ManveerA/Capstone/README.md

Repository for Team 34's Capstone project: Demonstration of Electromechanical Relationships in a Controlled Electric Motor.

Team 34 Members:

Manveer Aujla - manveeraujla0226@gmail.com

Gavin Feher - gavin.feher@gmail.com

Adam DePinto - depintoadam@gmail.com

Last updated: 2025-08-01
