ManveerA/Capstone/Oscilloscope_Data/README

CSV files of data captured from RIGOL DH0804 oscilloscope. Contains all signals from Sensing and Interfacing PCB.
