ManveerA/Capstone/Motor_Control/README

The Trinamic Motion Control Language (TMCL) script for controlling the TMCM-1640 controller/driver to drive the QBL4208 BLDC motor.
Author: Manveer Aujla
Contact: manveeraujla0226@gmail.com
