ManveerA/Capstone/Sensing_Interfacing_PCB/README

All design files for the custom Sensing and Interfacing (S&I) PCB.
Designer: Manveer Aujla
Contact: manveeraujla0226@gmail.com
