ManveerA/Capstone/Custom_Motor_Mount/v2 Capstone BLDC Motor Bracket.stl

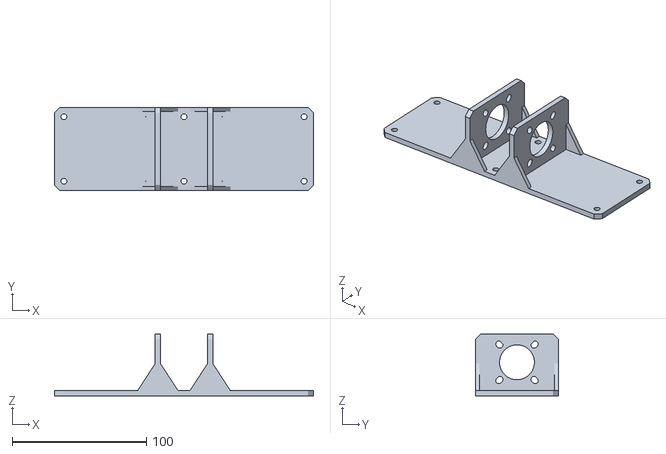
[picture p2: CAD file, 2025-07-31]
Custom_Motor_Mount/v2 Capstone BLDC Motor Bracket.stl
193.0 x 62.0 x 46.0
