ManveerA/Capstone/Sensing_Interfacing_PCB/B5B_PH_K_S/B5B-PH-K-S.STEP

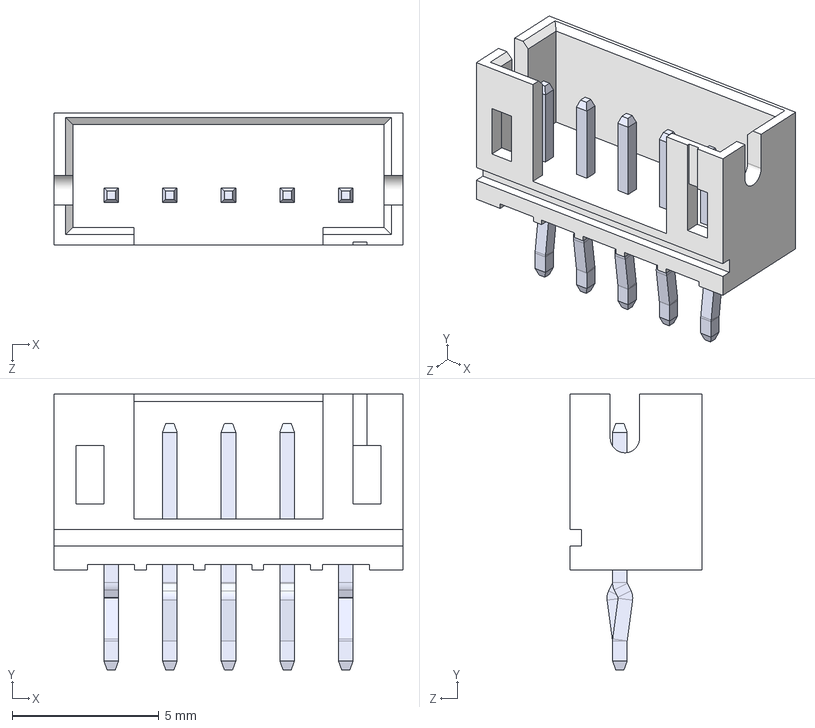
[picture p3: CAD file, 2025-07-31]
Sensing_Interfacing_PCB/B5B_PH_K_S/B5B-PH-K-S.STEP
11.9 x 9.40 x 4.50 mm
