ManveerA/Capstone/Sensing_Interfacing_PCB/LIB_ACS725LLCTR-05AB-T/ACS725LLCTR-05AB-T/3D/ACS725LLCTR-05AB-T.stp

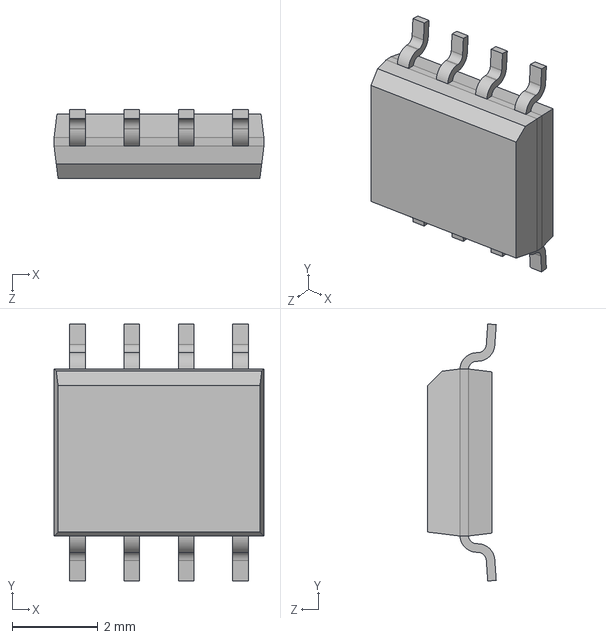
[picture p4: CAD file, 2025-07-31]
Sensing_Interfacing_PCB/LIB_ACS725LLCTR-05AB-T/ACS725LLCTR-05AB-T/3D/ACS725LLCTR-05AB-T.stp
4.90 x 6.00 x 1.60 mm
