ManveerA/Capstone/Sensing_Interfacing_PCB/LM358AP/LM358AP.step

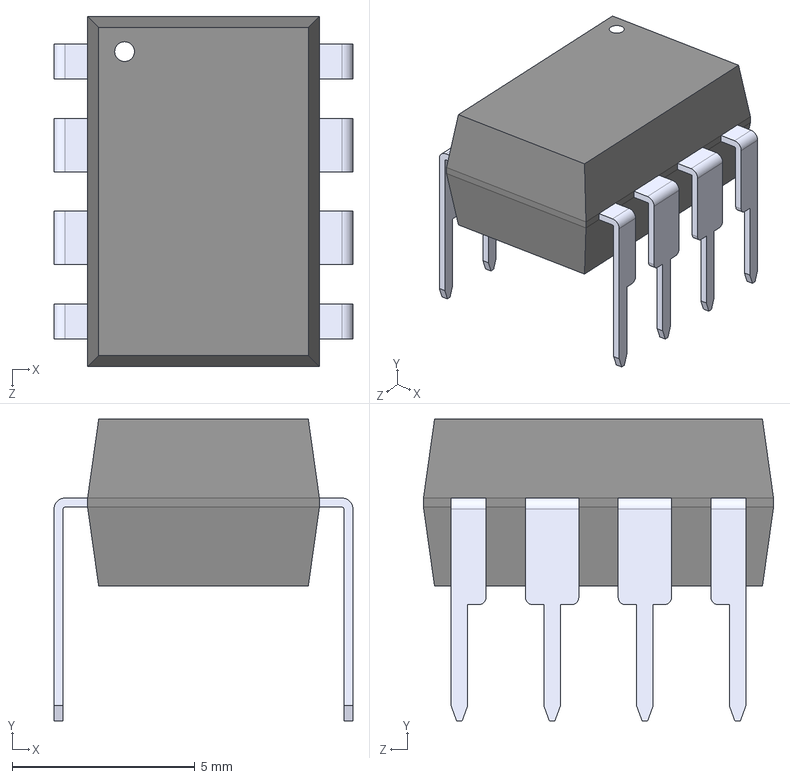
[picture p5: CAD file, 2025-07-31]
Sensing_Interfacing_PCB/LM358AP/LM358AP.step
8.19 x 8.26 x 9.59 mm
