ManveerA/Capstone/Sensing_Interfacing_PCB/61304021821/6130XX21821_61304021821.step

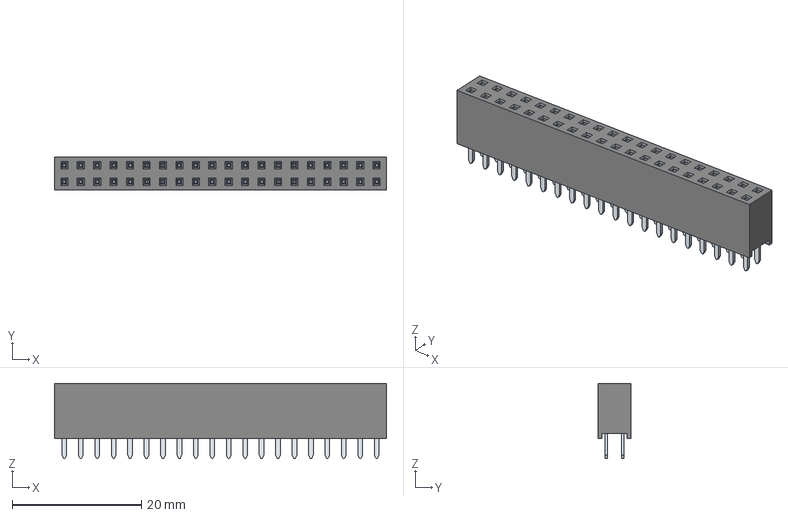
[picture p6: CAD file, 2025-07-31]
Sensing_Interfacing_PCB/61304021821/6130XX21821_61304021821.step
51.3 x 5.08 x 11.6 mm
6130xx21821_PIN x 40
