ManveerA/Capstone/Sensing_Interfacing_PCB/1935174/1935174.stp

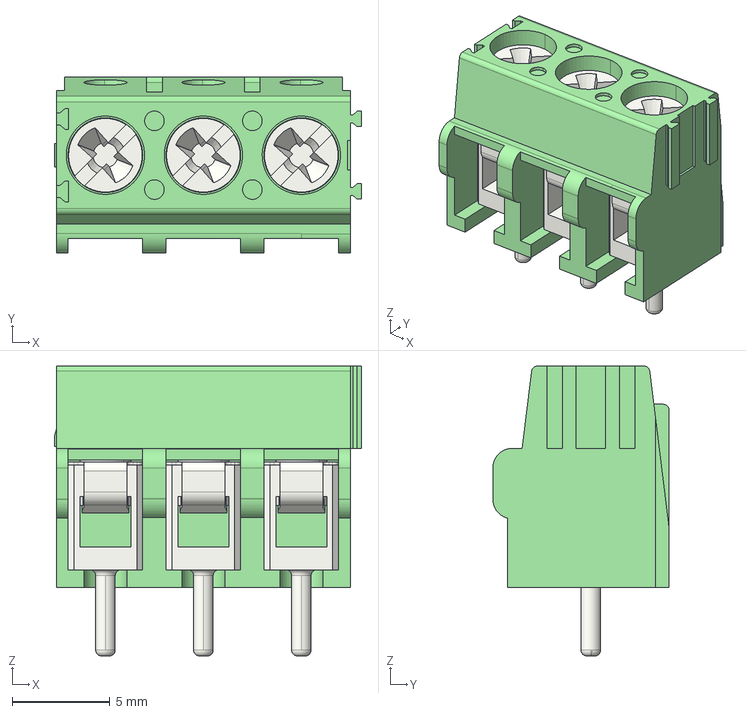
[picture p7: CAD file, 2025-07-31]
Sensing_Interfacing_PCB/1935174/1935174.stp
15.7 x 9.00 x 14.8 mm
