ManveerA/Capstone/Sensing_Interfacing_PCB/1935190/1935190.STEP

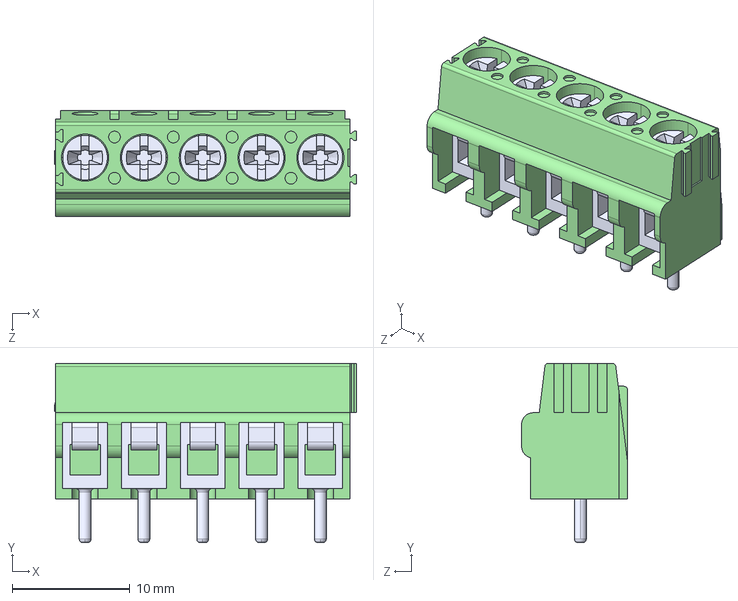
[picture p8: CAD file, 2025-07-31]
Sensing_Interfacing_PCB/1935190/1935190.STEP
25.7 x 15.2 x 9.00 mm
