ManveerA/Capstone/Sensing_Interfacing_PCB/1984646/1984646.stp

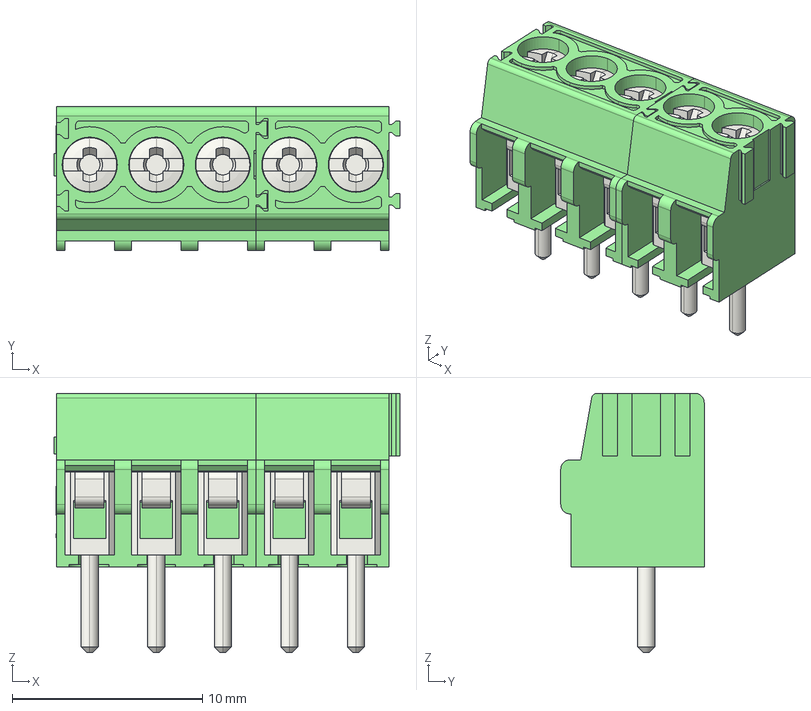
[picture p9: CAD file, 2025-07-31]
Sensing_Interfacing_PCB/1984646/1984646.stp
18.2 x 7.55 x 13.6 mm
