ManveerA/Capstone/Sensing_Interfacing_PCB/640456_3/640456-3.STEP

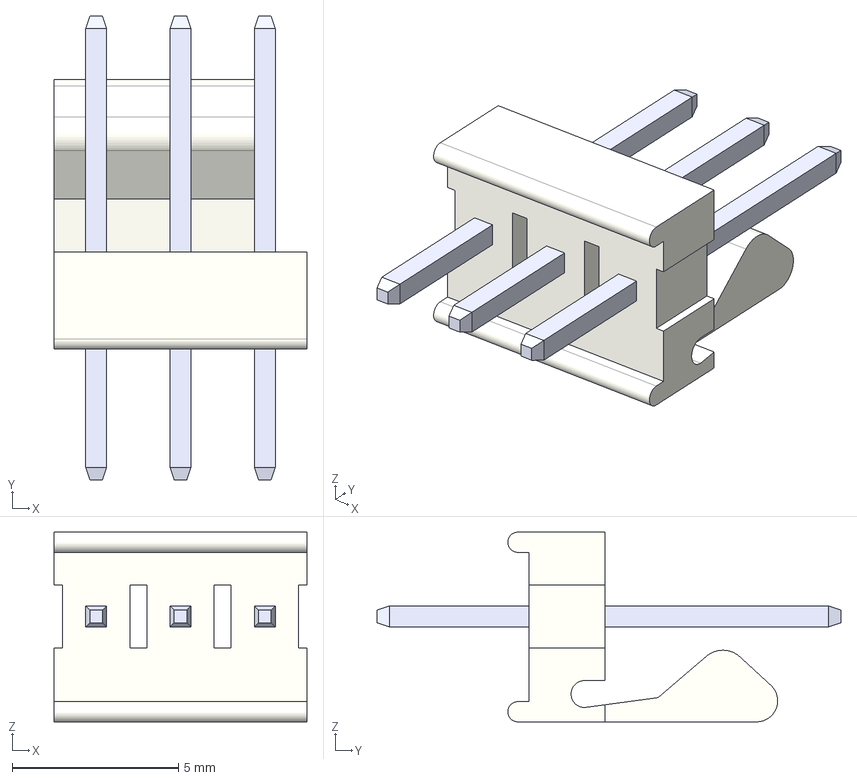
[picture p10: CAD file, 2025-07-31]
Sensing_Interfacing_PCB/640456_3/640456-3.STEP
7.62 x 14.0 x 5.71 mm
