ManveerA/Capstone/Sensing_Interfacing_PCB/Misc/971100154.stp

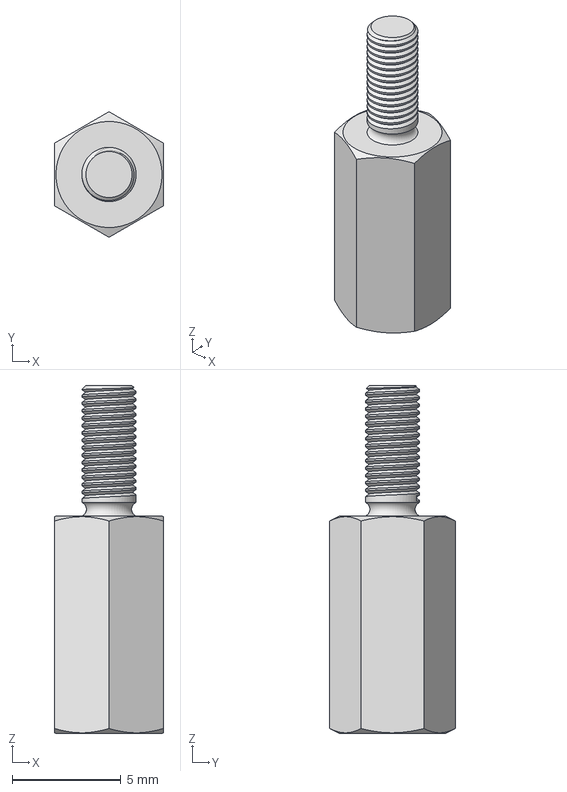
[picture p11: CAD file, 2025-07-31]
Sensing_Interfacing_PCB/Misc/971100154.stp
5.00 x 5.77 x 16.0 mm
