ManveerA/Capstone/(list of files, cad)

Other CAD files:
Custom_Motor_Mount/v2 Capstone BLDC Motor Bracket.f3d
Sensing_Interfacing_PCB/LIB_ACS725LLCTR-05AB-T/ACS725LLCTR-05AB-T/Allegro/soic127p600x175-8n.psm
Sensing_Interfacing_PCB/LIB_ACS725LLCTR-05AB-T/ACS725LLCTR-05AB-T/DEHDL/acs725llctr_05ab_t/chips/chips.prt
