ManveerA/Capstone/Sensing_Interfacing_PCB/Layout.pdf

# J5 U4 R15

# C8 R²⁵ U2

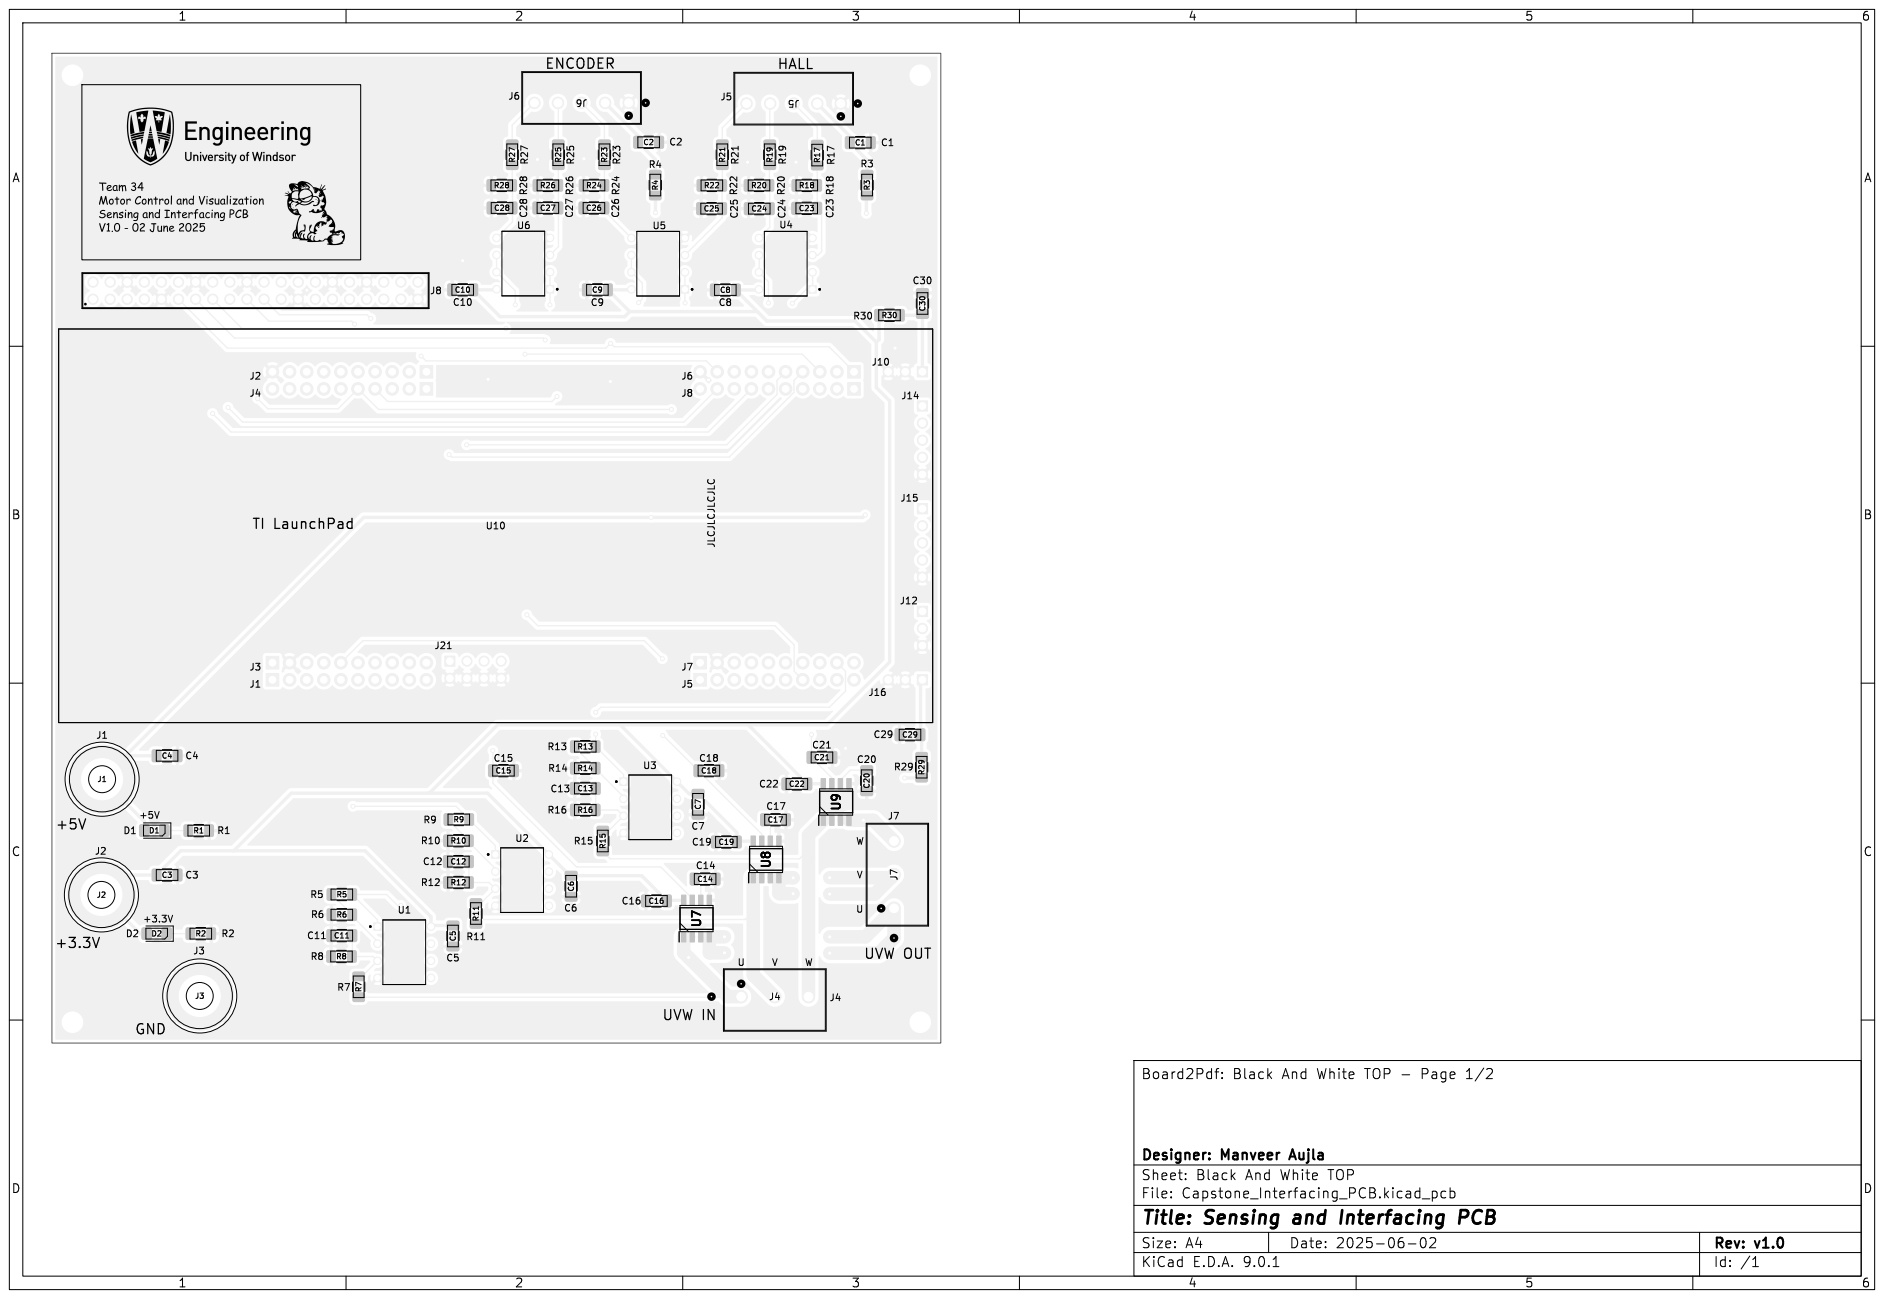
[picture p12: page 1]

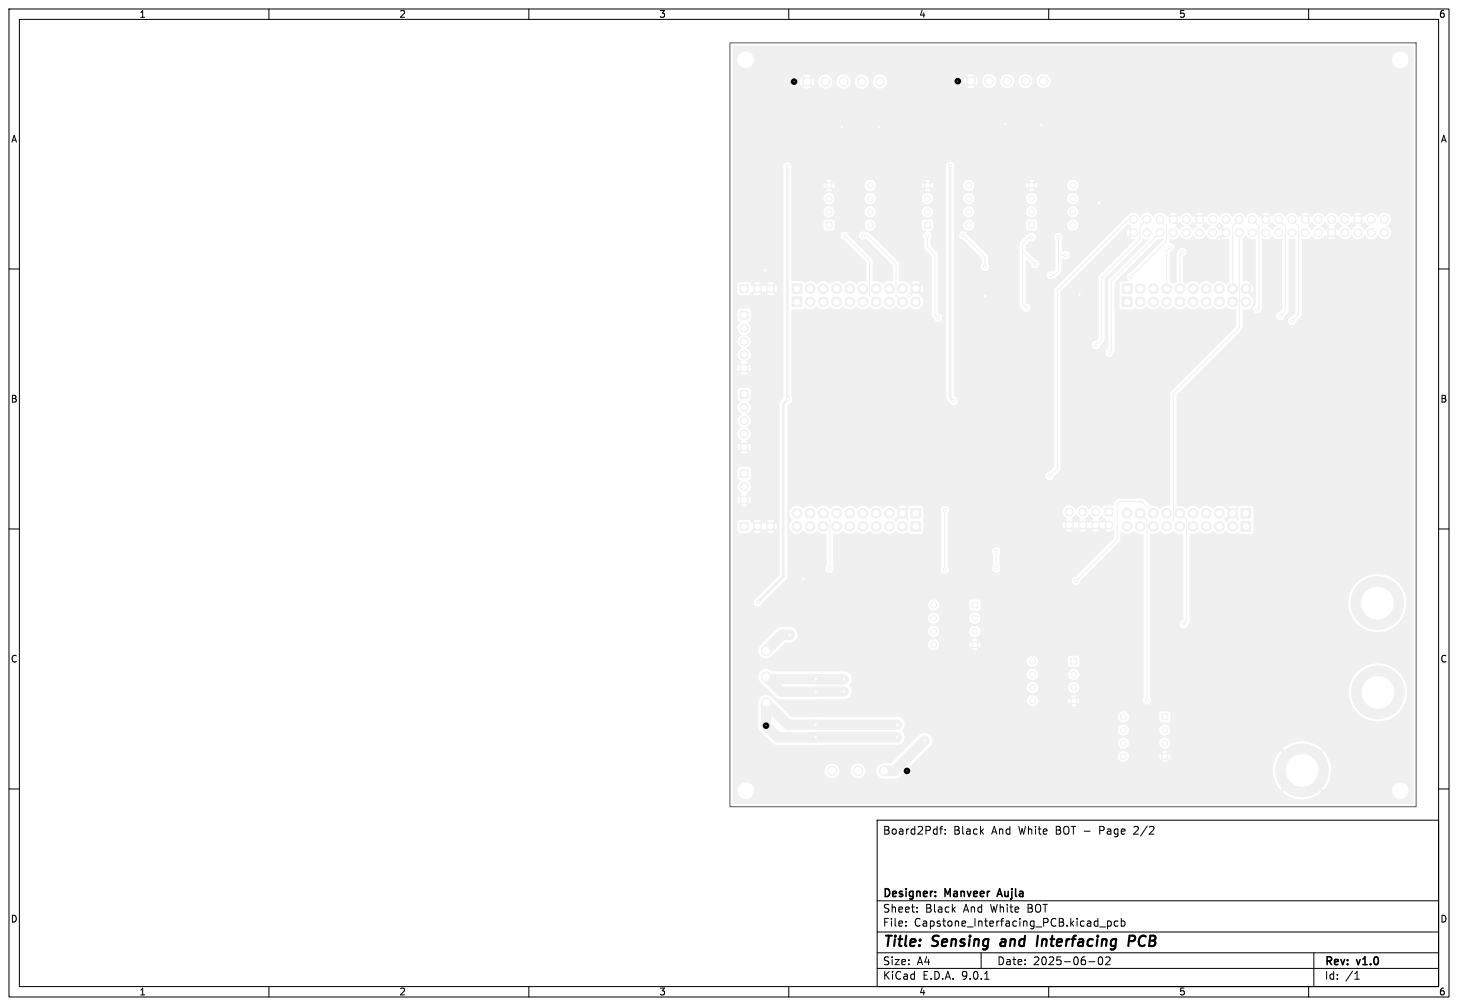
[picture p13: page 2]
D Date: 2025-06-02 KiCad; E.D.A. 9.0.1 Size: A4; Rev: v1.0; Id: /1 Title: Sensing and Interfacing; PCB; File: Capstone_Interfacing_PCB.kicad_pcb Sheet: Black; And; White; BOT Designer:; Manveer Aujla Board2Pdf:; Black; BOT -; Page 2/2
