ManveerA/Capstone/Sensing_Interfacing_PCB/Schematic.pdf

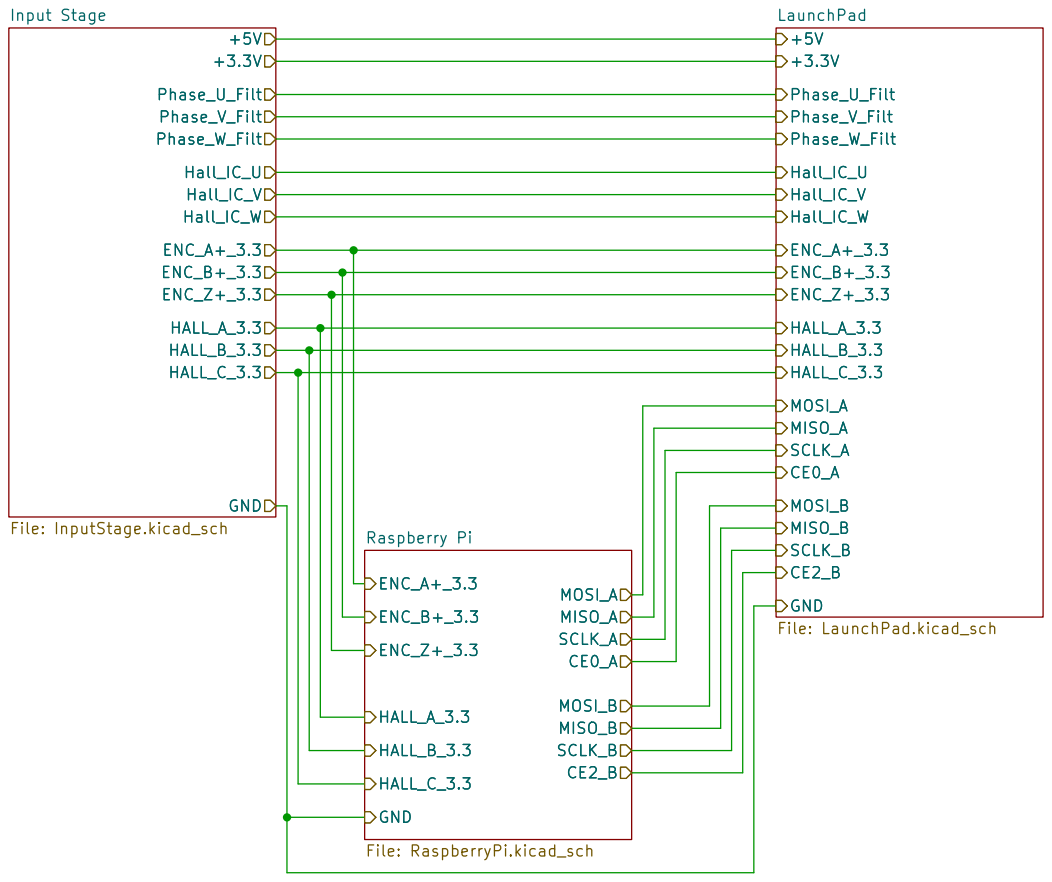
[picture p14: page 1]

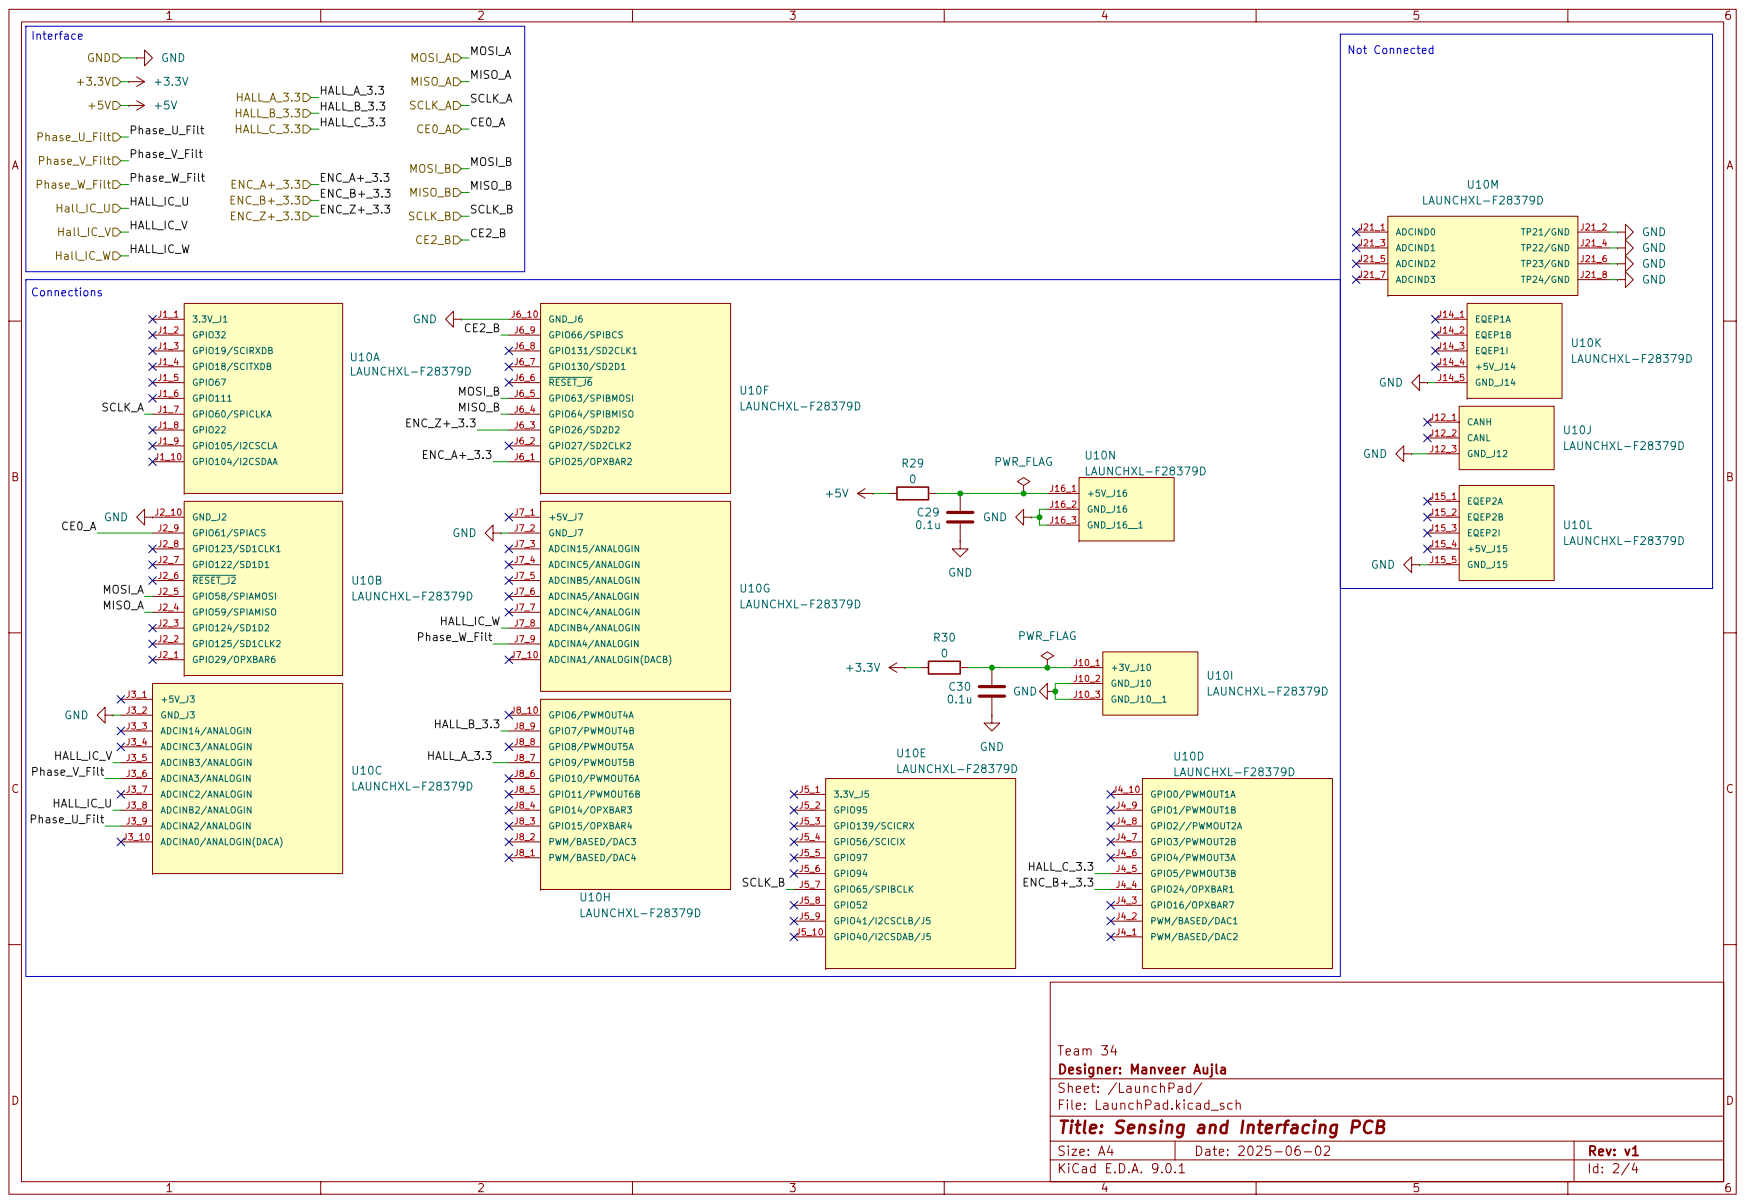
[picture p15: page 2]

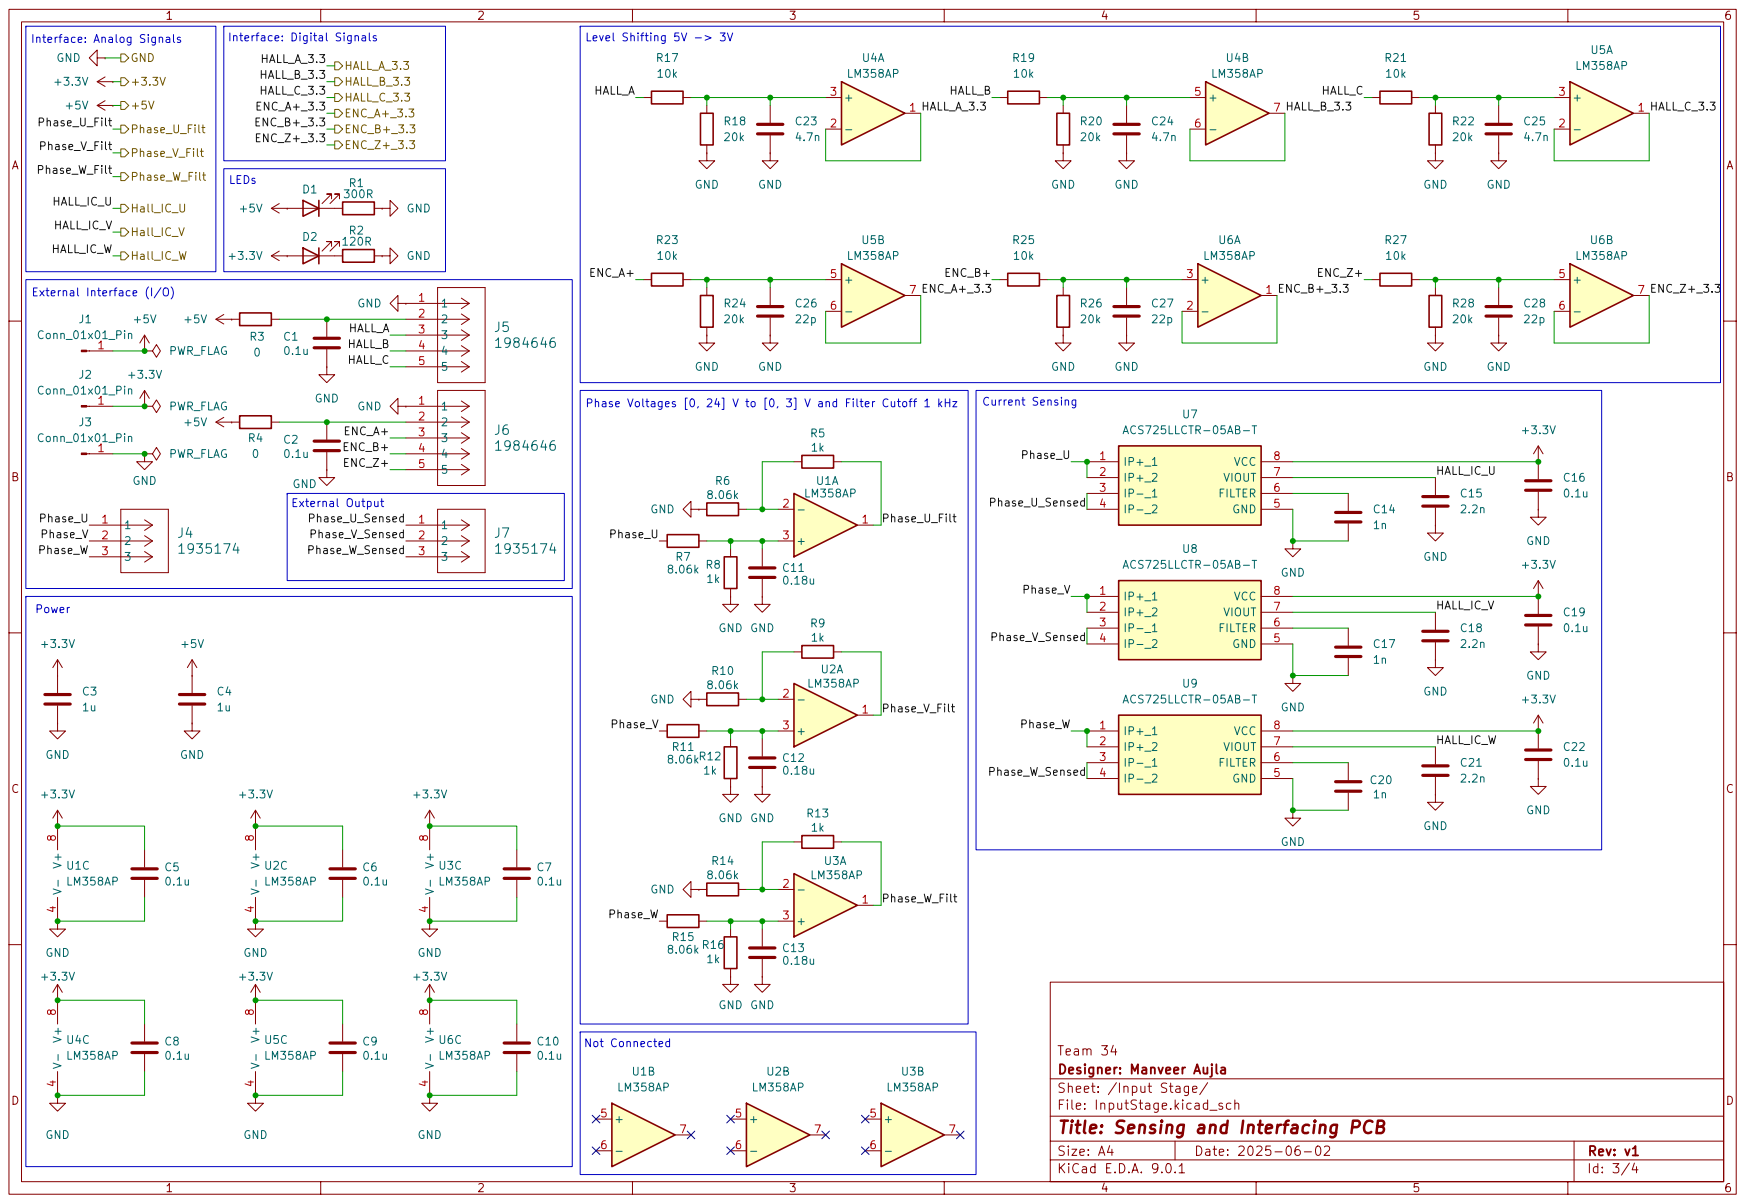
[picture p16: page 3]

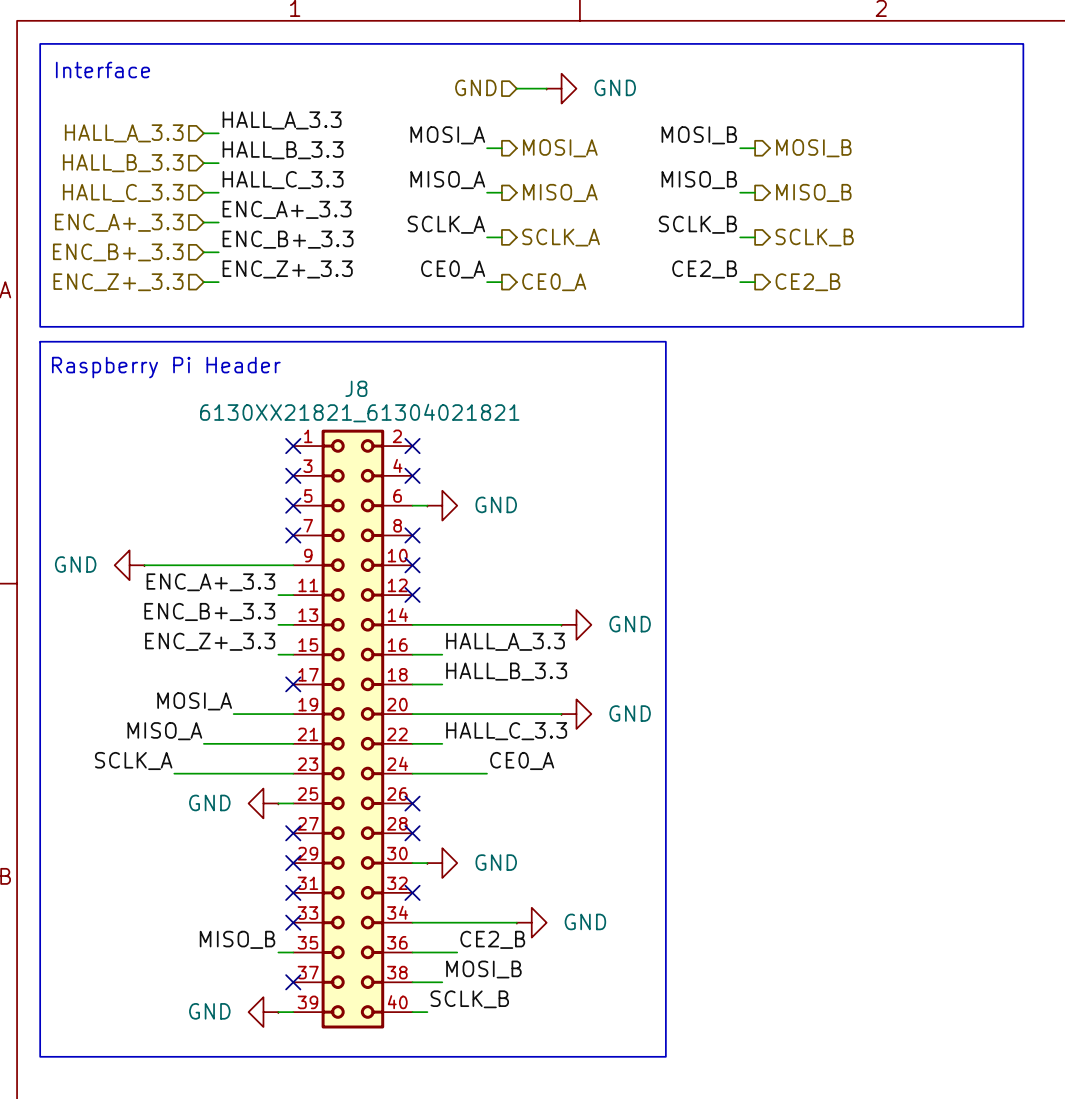
[picture p17: page 4]
