ManveerA/Capstone/Sensing_Interfacing_PCB/Capstone_Interfacing_PCB.kicad_pcb

## KiCad design Sensing_Interfacing_PCB/Capstone_Interfacing_PCB.kicad_pcb (2025-07-31)

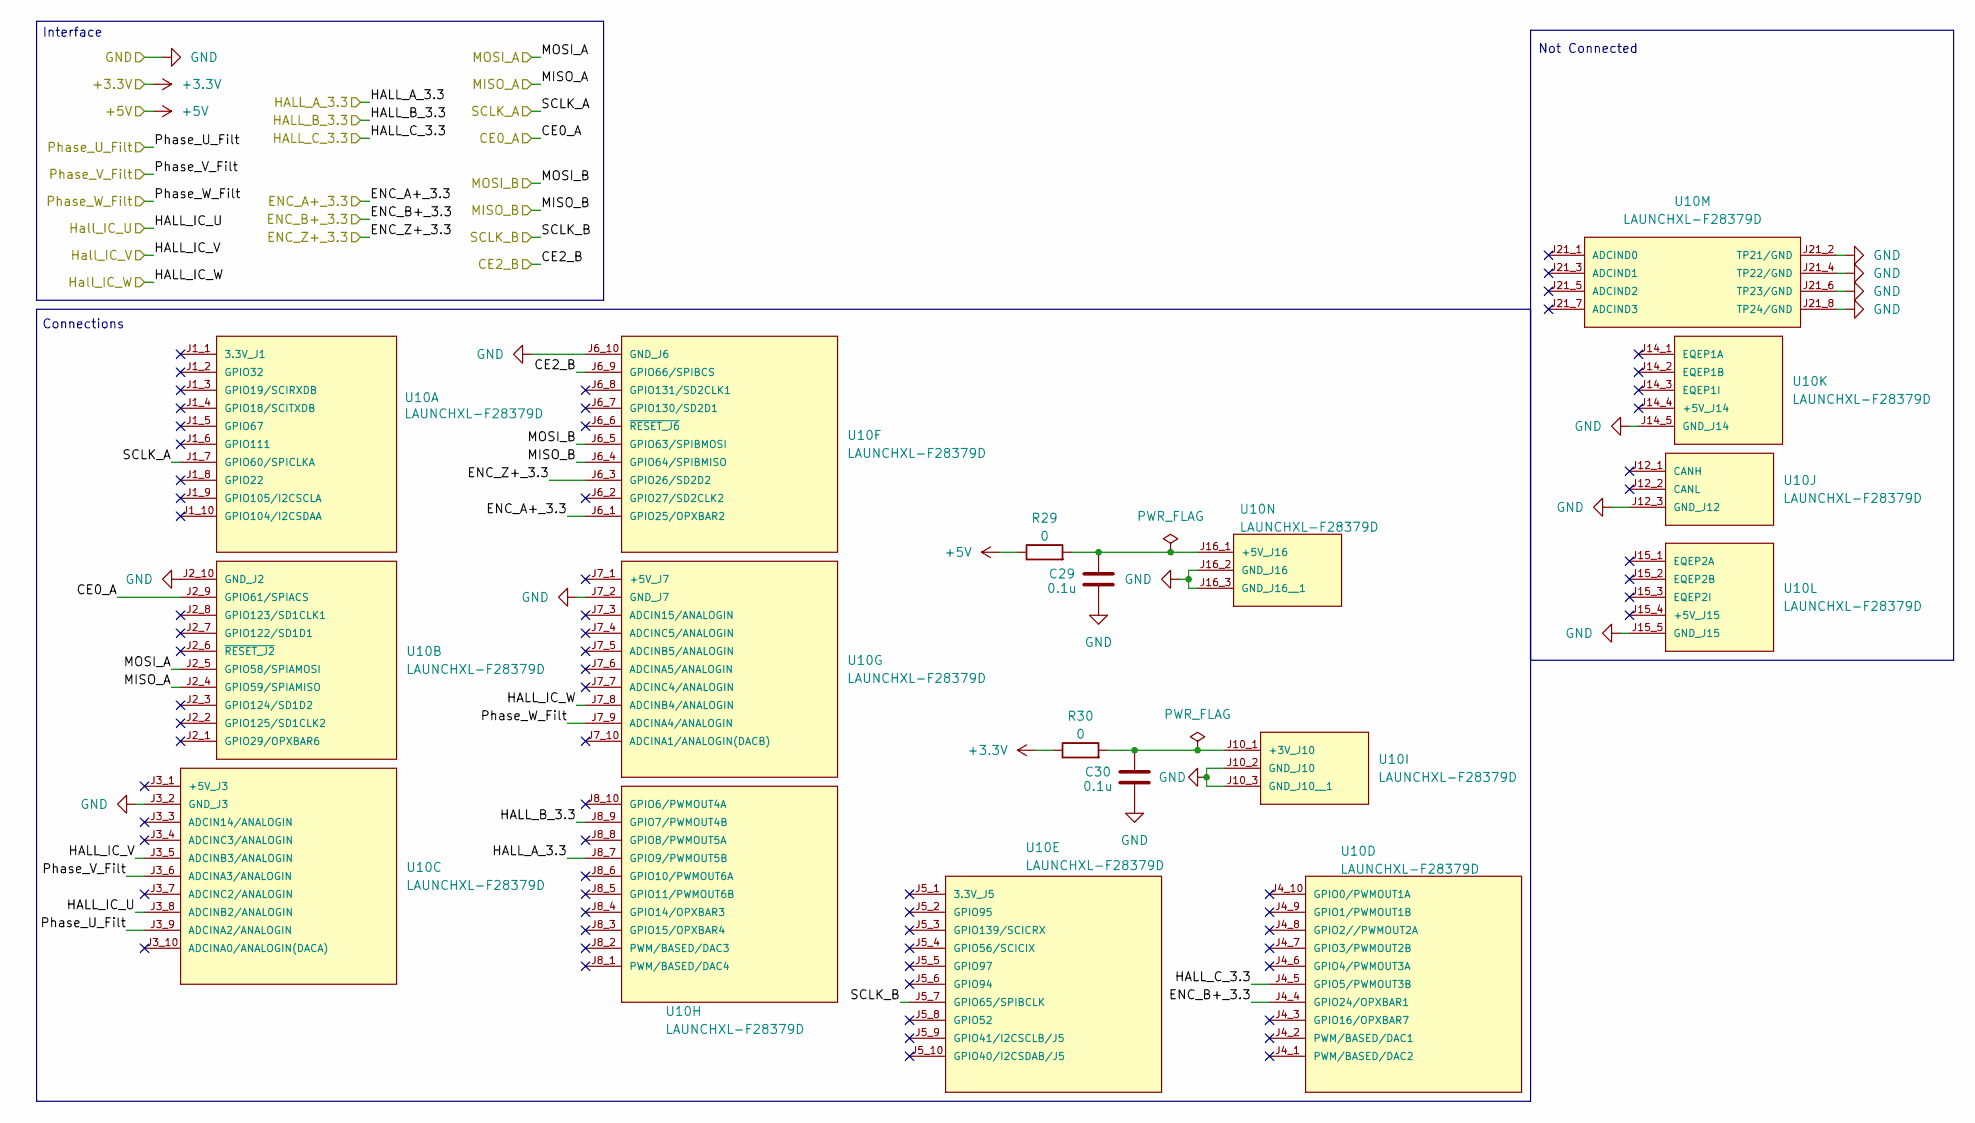
[picture p18: schematic LaunchPad.kicad_sch, Sensing and Interfacing PCB]

Parts:
C29, C30: 0.1u; C_1206_3216Metric_Pad1.33x1.80mm_HandSolder; Part Number C1206C104K4RACTU
R29, R30: 0; R_1206_3216Metric_Pad1.30x1.75mm_HandSolder; Part Number RMCF1206ZT0R00
U10: LAUNCHXL-F28379D; MOD_LAUNCHXL-F28379D; PARTREV 2.0

Connections:
+3.3V: R30.1; also elsewhere on the board
+5V: R29.1; also elsewhere on the board
/Input Stage/ENC_A+_3.3: U10.J6_1 (GPIO25/OPXBAR2); also elsewhere on the board
/Input Stage/ENC_B+_3.3: U10.J4_4 (GPIO24/OPXBAR1); also elsewhere on the board
/Input Stage/ENC_Z+_3.3: U10.J6_3 (GPIO26/SD2D2); also elsewhere on the board
/Input Stage/HALL_A_3.3: U10.J8_7 (GPIO9/PWMOUT5B); also elsewhere on the board
/Input Stage/HALL_B_3.3: U10.J8_9 (GPIO7/PWMOUT4B); also elsewhere on the board
/Input Stage/HALL_C_3.3: U10.J4_5 (GPIO5/PWMOUT3B); also elsewhere on the board
/Input Stage/HALL_IC_U: U10.J3_8 (ADCINB2/ANALOGIN); also elsewhere on the board
/Input Stage/HALL_IC_V: U10.J3_5 (ADCINB3/ANALOGIN); also elsewhere on the board
/Input Stage/HALL_IC_W: U10.J7_8 (ADCINB4/ANALOGIN); also elsewhere on the board
/Input Stage/Phase_U_Filt: U10.J3_9 (ADCINA2/ANALOGIN); also elsewhere on the board
/Input Stage/Phase_V_Filt: U10.J3_6 (ADCINA3/ANALOGIN); also elsewhere on the board
/Input Stage/Phase_W_Filt: U10.J7_9 (ADCINA4/ANALOGIN); also elsewhere on the board
/LaunchPad/CE0_A: U10.J2_9 (GPIO61/SPIACS); also elsewhere on the board
/LaunchPad/CE2_B: U10.J6_9 (GPIO66/SPIBCS); also elsewhere on the board
/LaunchPad/MISO_A: U10.J2_4 (GPIO59/SPIAMISO); also elsewhere on the board
/LaunchPad/MISO_B: U10.J6_4 (GPIO64/SPIBMISO); also elsewhere on the board
/LaunchPad/MOSI_A: U10.J2_5 (GPIO58/SPIAMOSI); also elsewhere on the board
/LaunchPad/MOSI_B: U10.J6_5 (GPIO63/SPIBMOSI); also elsewhere on the board
/LaunchPad/SCLK_A: U10.J1_7 (GPIO60/SPICLKA); also elsewhere on the board
/LaunchPad/SCLK_B: U10.J5_7 (GPIO65/SPIBCLK); also elsewhere on the board
GND: C29.2, C30.2, U10.J2_10 (GND_J2), U10.J3_2 (GND_J3), U10.J6_10 (GND_J6), U10.J7_2 (GND_J7), U10.J10_2 (GND_J10), U10.J10_3 (GND_J10__1), U10.J12_3 (GND_J12), U10.J14_5 (GND_J14), U10.J15_5 (GND_J15), U10.J16_2 (GND_J16), U10.J16_3 (GND_J16__1), U10.J21_2 (TP21/GND), U10.J21_4 (TP22/GND), U10.J21_6 (TP23/GND), U10.J21_8 (TP24/GND); also elsewhere on the board
unnamed: C30.1, R30.2, U10.J10_1 (+3V_J10)
unnamed: C29.1, R29.2, U10.J16_1 (+5V_J16)

Notes on the sheet:
Connections
Not Connected
Interface

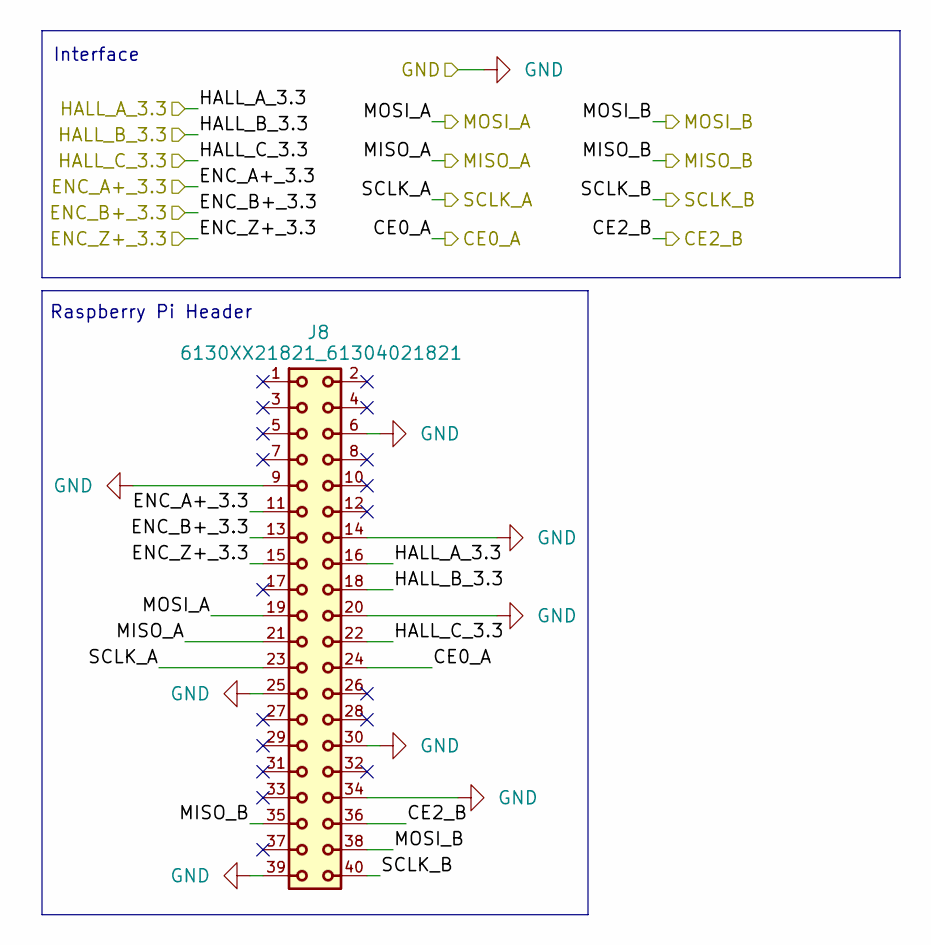
[picture p19: schematic RaspberryPi.kicad_sch, Sensing and Interfacing PCB]

Parts:
J8: 6130XX21821_61304021821; 61304021821; Part Number 61304021821

Connections:
/Input Stage/ENC_A+_3.3: J8.11; also elsewhere on the board
/Input Stage/ENC_B+_3.3: J8.13; also elsewhere on the board
/Input Stage/ENC_Z+_3.3: J8.15; also elsewhere on the board
/Input Stage/HALL_A_3.3: J8.16; also elsewhere on the board
/Input Stage/HALL_B_3.3: J8.18; also elsewhere on the board
/Input Stage/HALL_C_3.3: J8.22; also elsewhere on the board
/LaunchPad/CE0_A: J8.24; also elsewhere on the board
/LaunchPad/CE2_B: J8.36; also elsewhere on the board
/LaunchPad/MISO_A: J8.21; also elsewhere on the board
/LaunchPad/MISO_B: J8.35; also elsewhere on the board
/LaunchPad/MOSI_A: J8.19; also elsewhere on the board
/LaunchPad/MOSI_B: J8.38; also elsewhere on the board
/LaunchPad/SCLK_A: J8.23; also elsewhere on the board
/LaunchPad/SCLK_B: J8.40; also elsewhere on the board
GND: J8.6, J8.9, J8.14, J8.20, J8.25, J8.30, J8.34, J8.39; also elsewhere on the board

Notes on the sheet:
Interface
Raspberry Pi Header

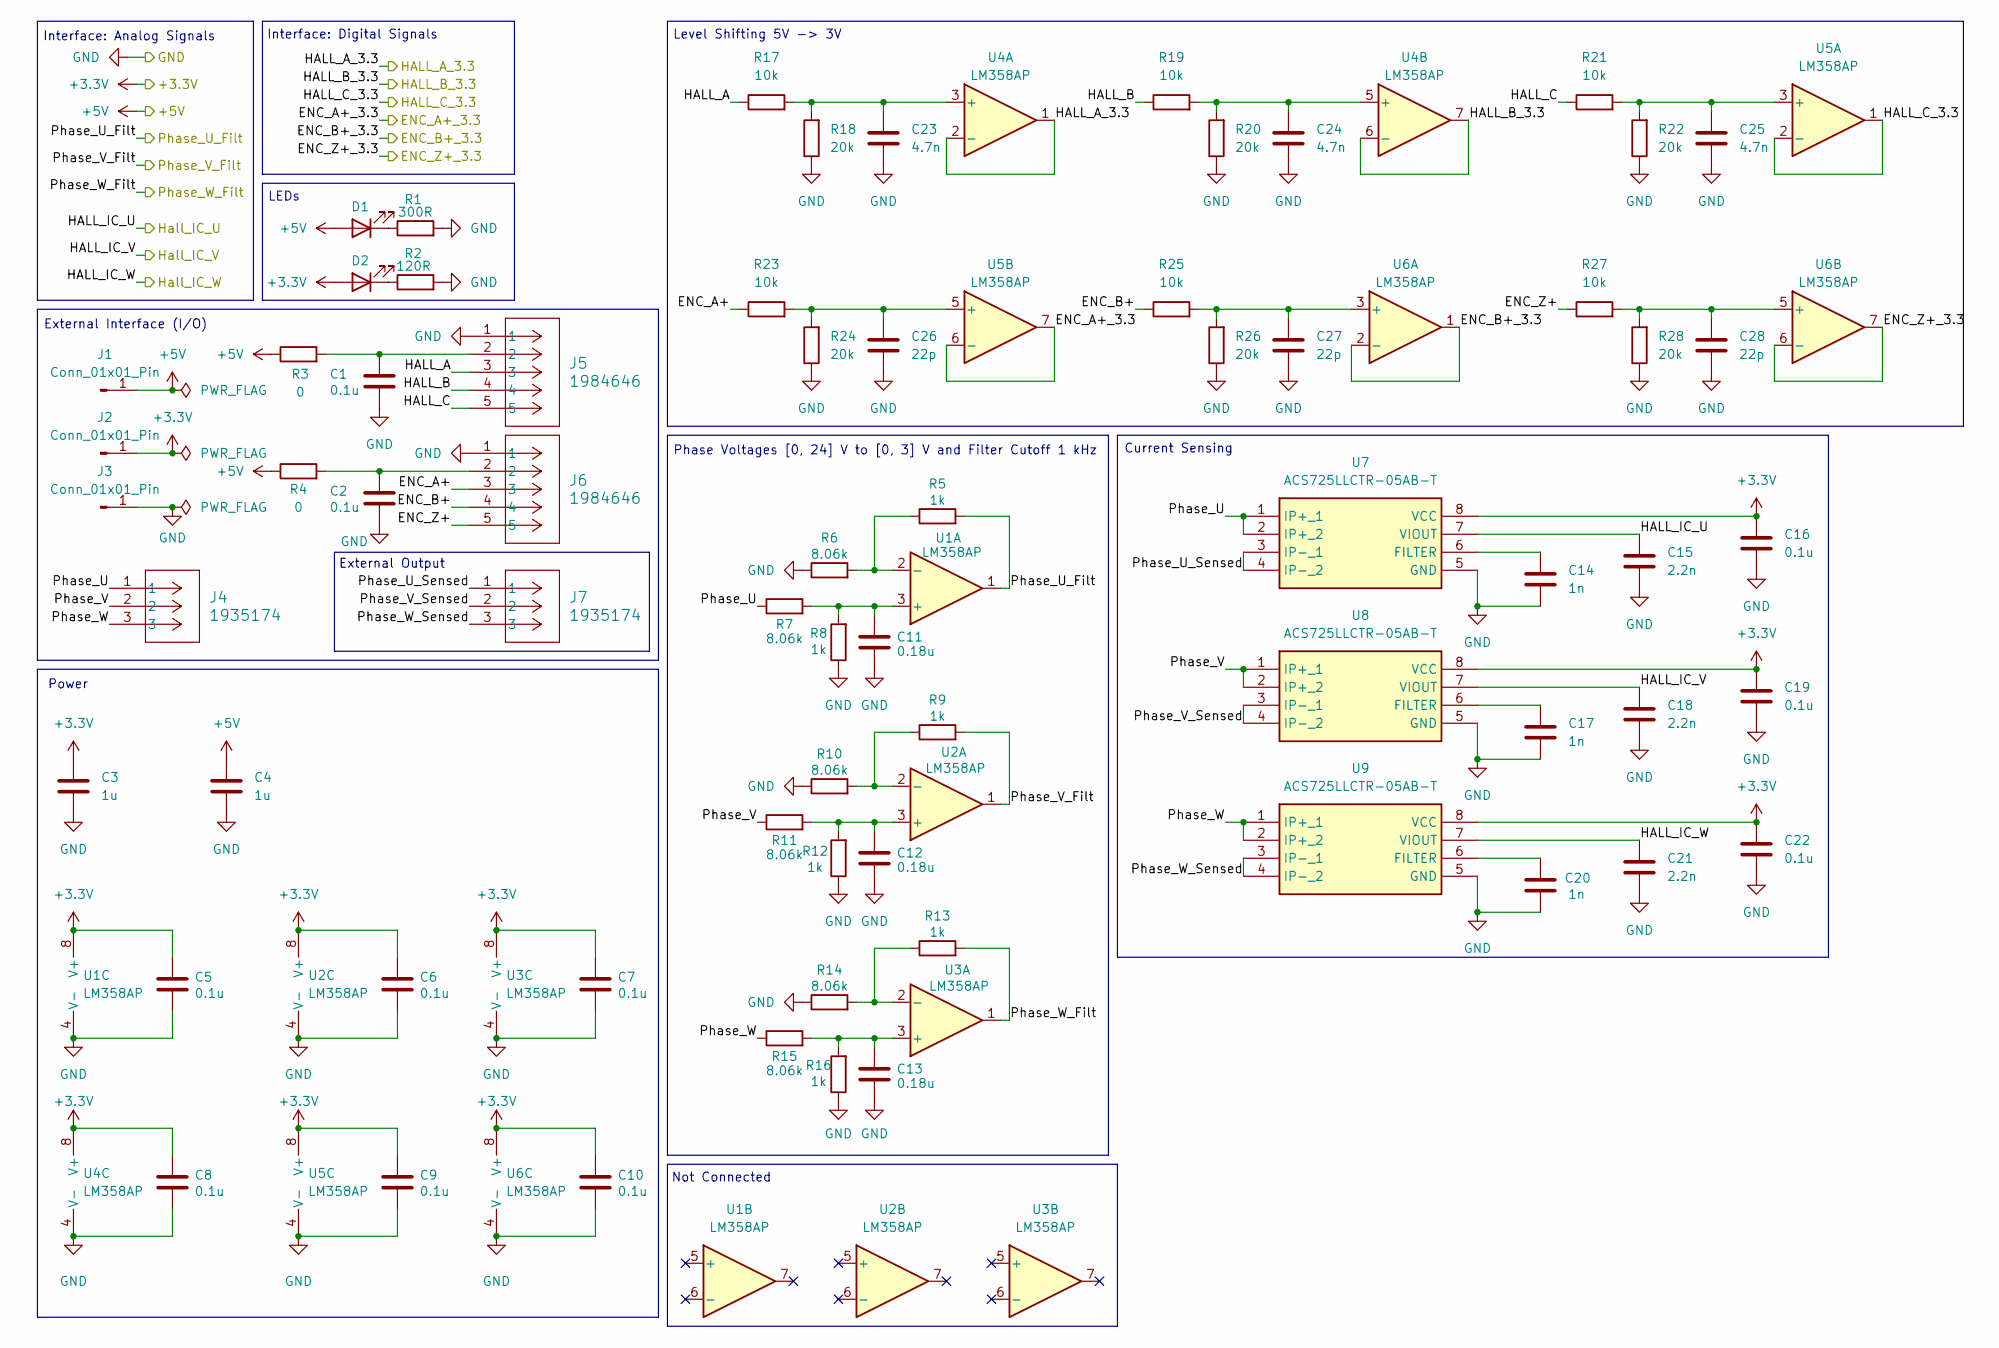
[picture p20: schematic InputStage.kicad_sch, Sensing and Interfacing PCB]

Parts:
C1, C2, C5, C6, C7, C8, C9, C10, C16, C19, C22: 0.1u; C_1206_3216Metric_Pad1.33x1.80mm_HandSolder; Part Number C1206C104K4RACTU
C3: 1u; C_1206_3216Metric_Pad1.33x1.80mm_HandSolder; Part Number GRM319R71A105KA01D
C4: 1u; C_1206_3216Metric_Pad1.33x1.80mm_HandSolder; Part Number GRM319R71C105KAA3D
C11, C12, C13: 0.18u; C_1206_3216Metric_Pad1.33x1.80mm_HandSolder; Part Number CC1206KKX7R9BB184
C14, C17, C20: 1n; C_1206_3216Metric_Pad1.33x1.80mm_HandSolder; Part Number CC1206FRNPO9BN102
C15, C18, C21: 2.2n; C_1206_3216Metric_Pad1.33x1.80mm_HandSolder; Part Number C1206C222K4HACAUTO
C23, C24, C25: 4.7n; C_1206_3216Metric_Pad1.33x1.80mm_HandSolder; Part Number 885012208025
C26, C27, C28: 22p; C_1206_3216Metric_Pad1.33x1.80mm_HandSolder; Part Number C1206C220F4HACTU
D1, D2: LTST-C150GKT; LED_1206_3216Metric_Pad1.42x1.75mm_HandSolder; Part Number LTST-C150GKT
J1, J2, J3: Conn_01x01_Pin; Banana_Jack_1Pin; Part Number BU-P72930-2
J4, J7: 1935174; CONN_1935174_PXC; Part Number 1935174
J5, J6: 1984646; CONN_1984646_PXC; Part Number 1984646
R1: 300R; R_1206_3216Metric_Pad1.30x1.75mm_HandSolder; Part Number RMCF1206FT300R
R2: 120R; R_1206_3216Metric_Pad1.30x1.75mm_HandSolder; Part Number RMCF1206FT120R
R3, R4: 0; R_1206_3216Metric_Pad1.30x1.75mm_HandSolder; Part Number RMCF1206ZT0R00
R5, R8, R9, R12, R13, R16: 1k; R_1206_3216Metric_Pad1.30x1.75mm_HandSolder; Part Number RNCP1206FTD1K00
R6, R7, R10, R11, R14, R15: 8.06k; R_1206_3216Metric_Pad1.30x1.75mm_HandSolder; Part Number RNCP1206FTD8K06
R17, R19, R21, R23, R25, R27: 10k; R_1206_3216Metric_Pad1.30x1.75mm_HandSolder; Part Number RNCF1206DTE10K0
R18, R20, R22, R24, R26, R28: 20k; R_1206_3216Metric_Pad1.30x1.75mm_HandSolder; Part Number RNCF1206BTE20K0
U1, U2, U3, U4, U5, U6: LM358AP; DIP794W45P254L959H508Q8; Part Number LM358AP
U7, U8, U9: ACS725LLCTR-05AB-T; SOIC127P600X175-8N; Mouser Part Number 250-725LLCTR05ABT

Connections:
+3.3V: C3.1, C5.1, C6.1, C7.1, C8.1, C9.1, C10.1, C16.1, C19.1, C22.1, D2.2 (A), J2.1, U1.8 (V+), U2.8 (V+), U3.8 (V+), U4.8 (V+), U5.8 (V+), U6.8 (V+), U7.8 (VCC), U8.8 (VCC), U9.8 (VCC); also elsewhere on the board
+5V: C4.1, D1.2 (A), J1.1, R3.1, R4.1; also elsewhere on the board
/Input Stage/ENC_A+: J6.3, R23.1
/Input Stage/ENC_A+_3.3: U5.6 (-), U5.7; also elsewhere on the board
/Input Stage/ENC_B+: J6.4, R25.1
/Input Stage/ENC_B+_3.3: U6.1, U6.2 (-); also elsewhere on the board
/Input Stage/ENC_Z+: J6.5, R27.1
/Input Stage/ENC_Z+_3.3: U6.6 (-), U6.7; also elsewhere on the board
/Input Stage/HALL_A: J5.3, R17.1
/Input Stage/HALL_A_3.3: U4.1, U4.2 (-); also elsewhere on the board
/Input Stage/HALL_B: J5.4, R19.1
/Input Stage/HALL_B_3.3: U4.6 (-), U4.7; also elsewhere on the board
/Input Stage/HALL_C: J5.5, R21.1
/Input Stage/HALL_C_3.3: U5.1, U5.2 (-); also elsewhere on the board
/Input Stage/HALL_IC_U: C15.1, U7.7 (VIOUT); also elsewhere on the board
/Input Stage/HALL_IC_V: C18.1, U8.7 (VIOUT); also elsewhere on the board
/Input Stage/HALL_IC_W: C21.1, U9.7 (VIOUT); also elsewhere on the board
/Input Stage/Phase_U: J4.1, R7.1, U7.1 (IP+_1), U7.2 (IP+_2)
/Input Stage/Phase_U_Filt: R5.2, U1.1; also elsewhere on the board
/Input Stage/Phase_U_Sensed: J7.1, U7.3 (IP-_1), U7.4 (IP-_2)
/Input Stage/Phase_V: J4.2, R11.1, U8.1 (IP+_1), U8.2 (IP+_2)
/Input Stage/Phase_V_Filt: R9.2, U2.1; also elsewhere on the board
/Input Stage/Phase_V_Sensed: J7.2, U8.3 (IP-_1), U8.4 (IP-_2)
/Input Stage/Phase_W: J4.3, R15.1, U9.1 (IP+_1), U9.2 (IP+_2)
/Input Stage/Phase_W_Filt: R13.2, U3.1; also elsewhere on the board
/Input Stage/Phase_W_Sensed: J7.3, U9.3 (IP-_1), U9.4 (IP-_2)
GND: C1.2, C2.2, C3.2, C4.2, C5.2, C6.2, C7.2, C8.2, C9.2, C10.2, C11.2, C12.2, C13.2, C14.2, C15.2, C16.2, C17.2, C18.2, C19.2, C20.2, C21.2, C22.2, C23.2, C24.2, C25.2, C26.2, C27.2, C28.2, J3.1, J5.1, J6.1, R1.2, R2.2, R6.1, R8.1, R10.1, R12.1, R14.1, R16.1, R18.1, R20.1, R22.1, R24.1, R26.1, R28.1, U1.4 (V-), U2.4 (V-), U3.4 (V-), U4.4 (V-), U5.4 (V-), U6.4 (V-), U7.5 (GND), U8.5 (GND), U9.5 (GND); also elsewhere on the board
unnamed: C1.1, J5.2, R3.2
unnamed: C2.1, J6.2, R4.2
unnamed: D1.1 (K), R1.1
unnamed: D2.1 (K), R2.1
unnamed: C11.1, R7.2, R8.2, U1.3 (+)
unnamed: R5.1, R6.2, U1.2 (-)
unnamed: C12.1, R11.2, R12.2, U2.3 (+)
unnamed: R9.1, R10.2, U2.2 (-)
unnamed: C13.1, R15.2, R16.2, U3.3 (+)
unnamed: R13.1, R14.2, U3.2 (-)
unnamed: C23.1, R17.2, R18.2, U4.3 (+)
unnamed: C24.1, R19.2, R20.2, U4.5 (+)
unnamed: C25.1, R21.2, R22.2, U5.3 (+)
unnamed: C26.1, R23.2, R24.2, U5.5 (+)
unnamed: C27.1, R25.2, R26.2, U6.3 (+)
unnamed: C28.1, R27.2, R28.2, U6.5 (+)
unnamed: C14.1, U7.6 (FILTER)
unnamed: C17.1, U8.6 (FILTER)
unnamed: C20.1, U9.6 (FILTER)

Notes on the sheet:
Interface: Digital Signals
External Output
Power
Phase Voltages [0, 24] V to [0, 3] V and Filter Cutoff 1 kHz
LEDs
External Interface (I/O)
Current Sensing
Interface: Analog Signals
Level Shifting 5V -> 3V
Not Connected

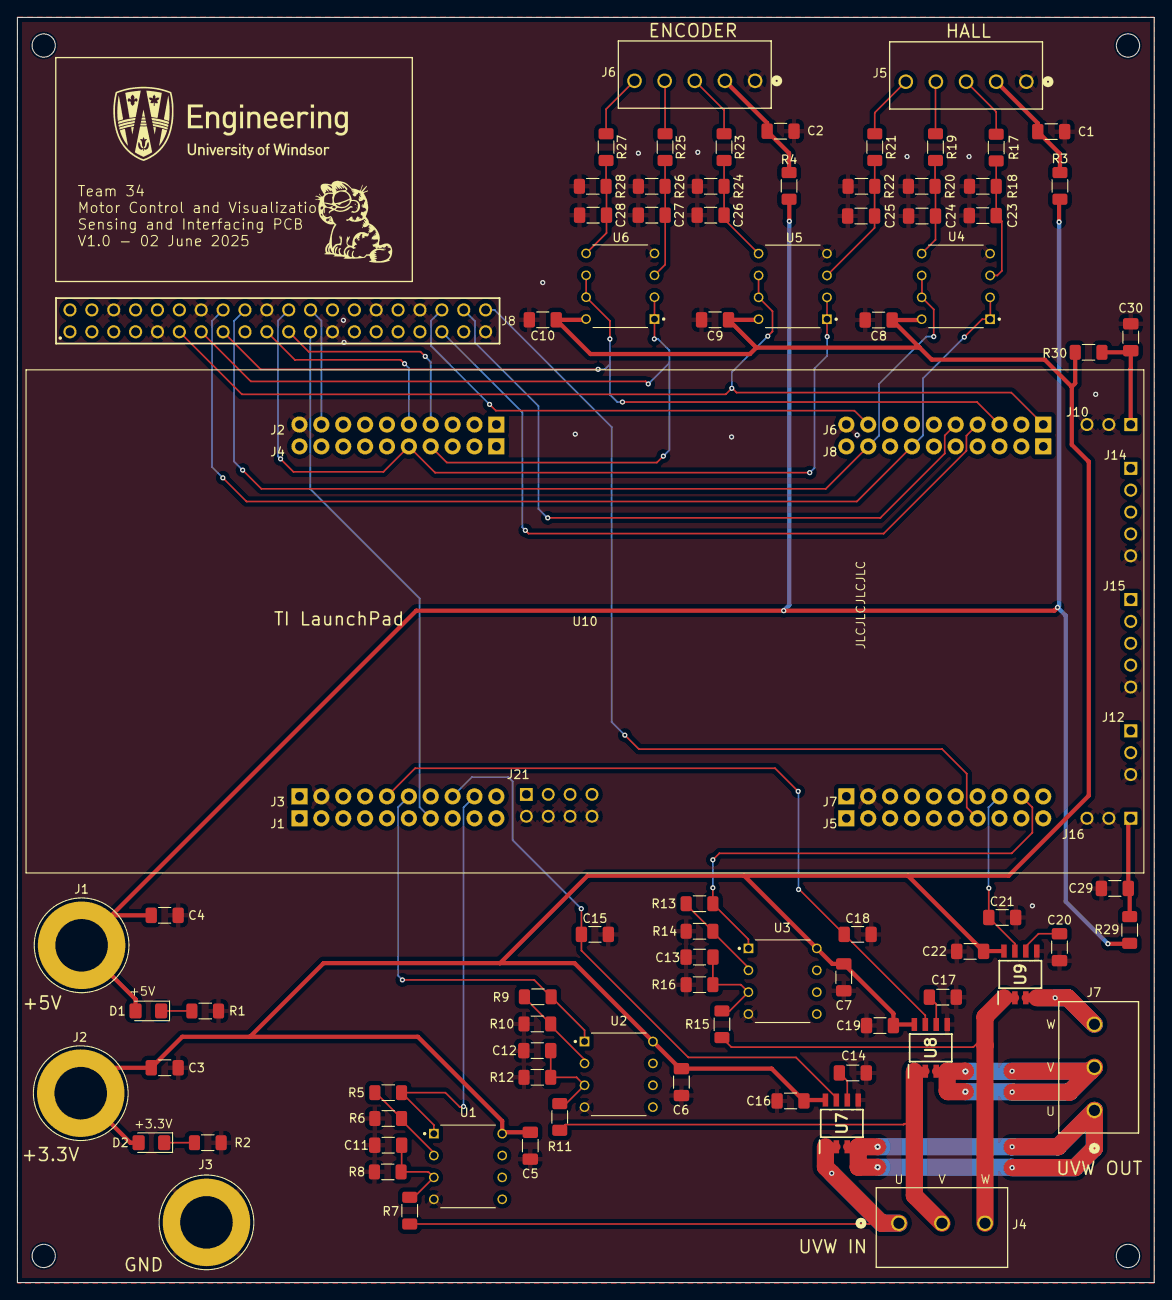
[picture p21: board Capstone_Interfacing_PCB.kicad_pcb from above]

Board: 2 copper layers, 132.0 x 146.9 mm, 80 parts (0 on the bottom side), 56 nets.
